candykingdom/gps-tracker/hardware/ref/board back.png

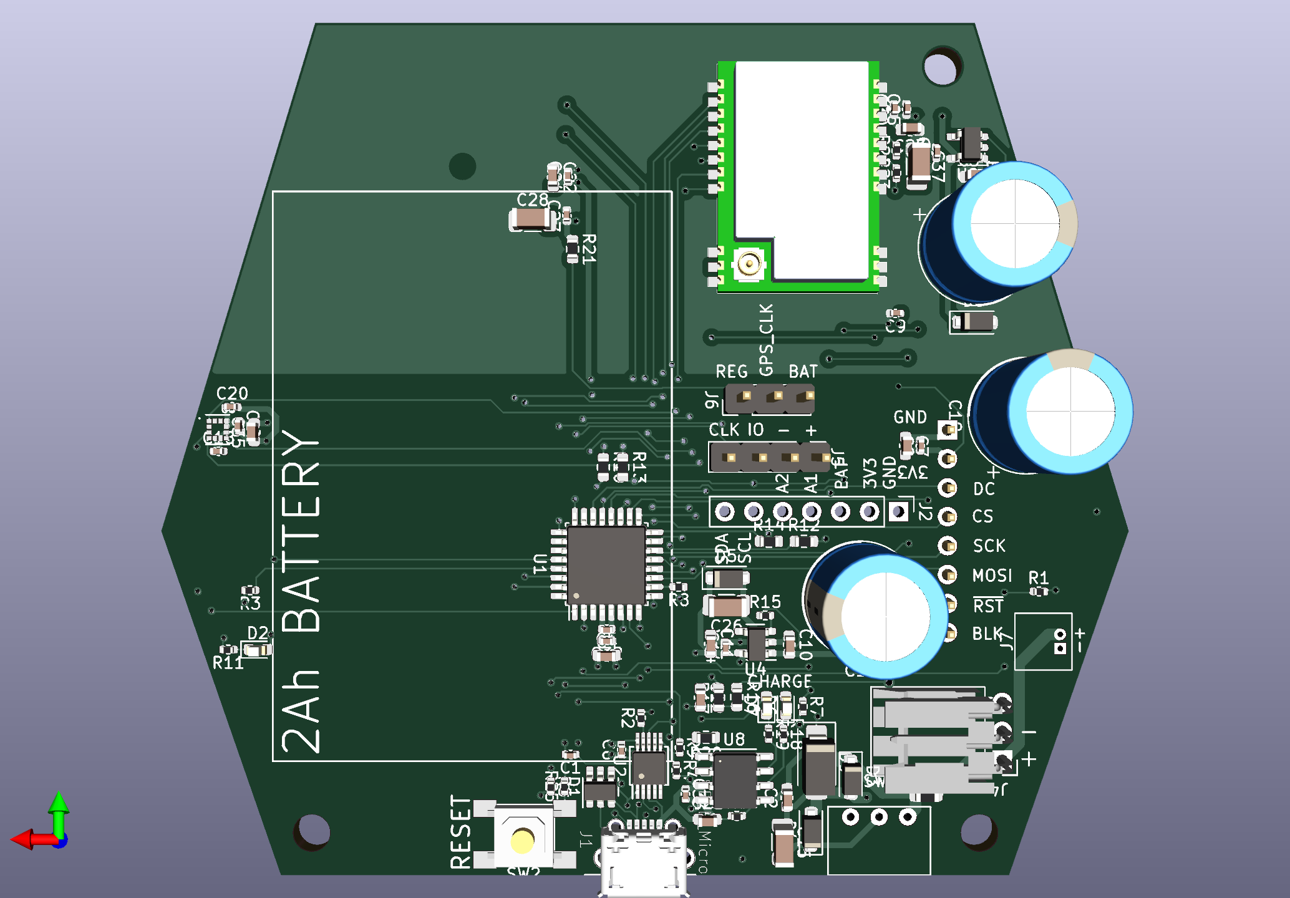
hardware/ref/board back.png
