candykingdom/gps-tracker/hardware/ref/board dimensions.png

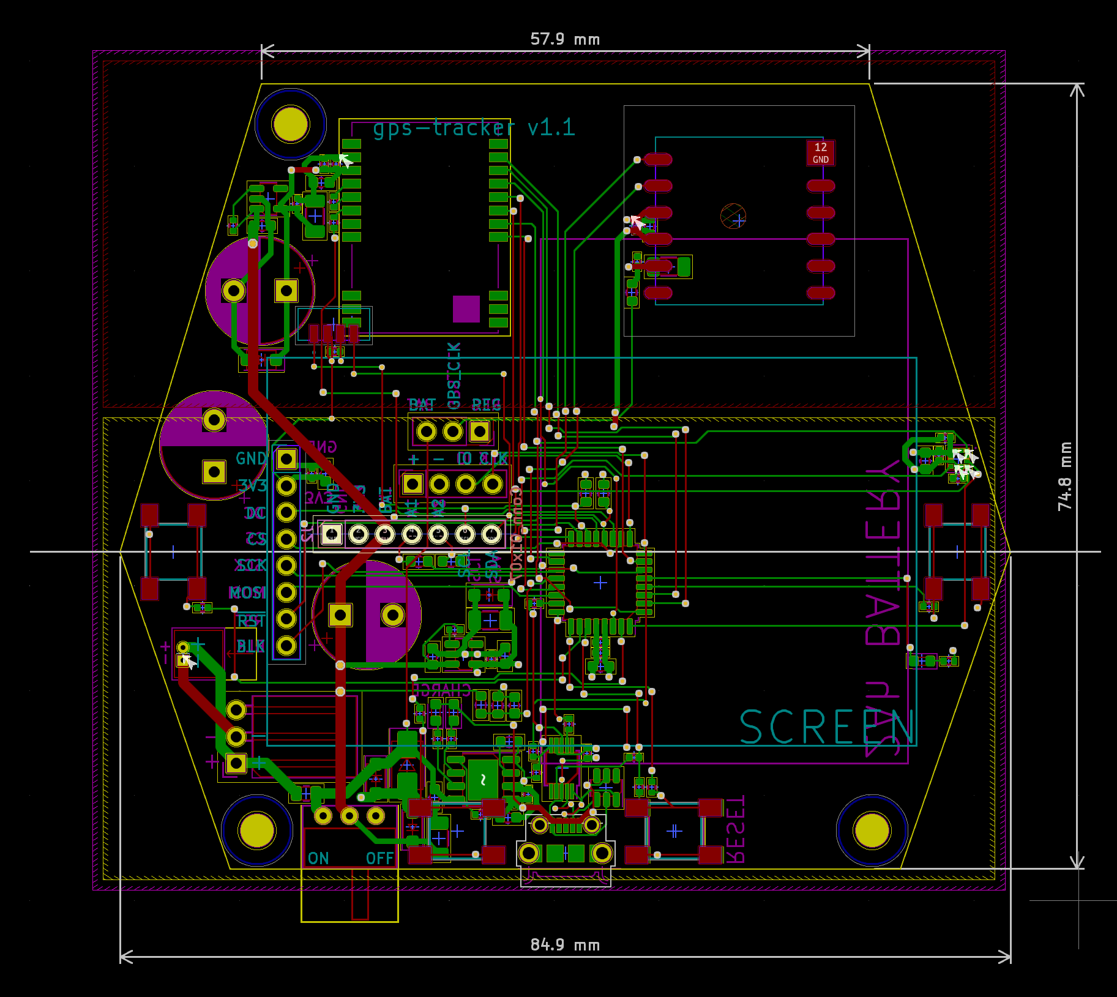
hardware/ref/board dimensions.png
