candykingdom/gps-tracker/hardware/ref/board front.png

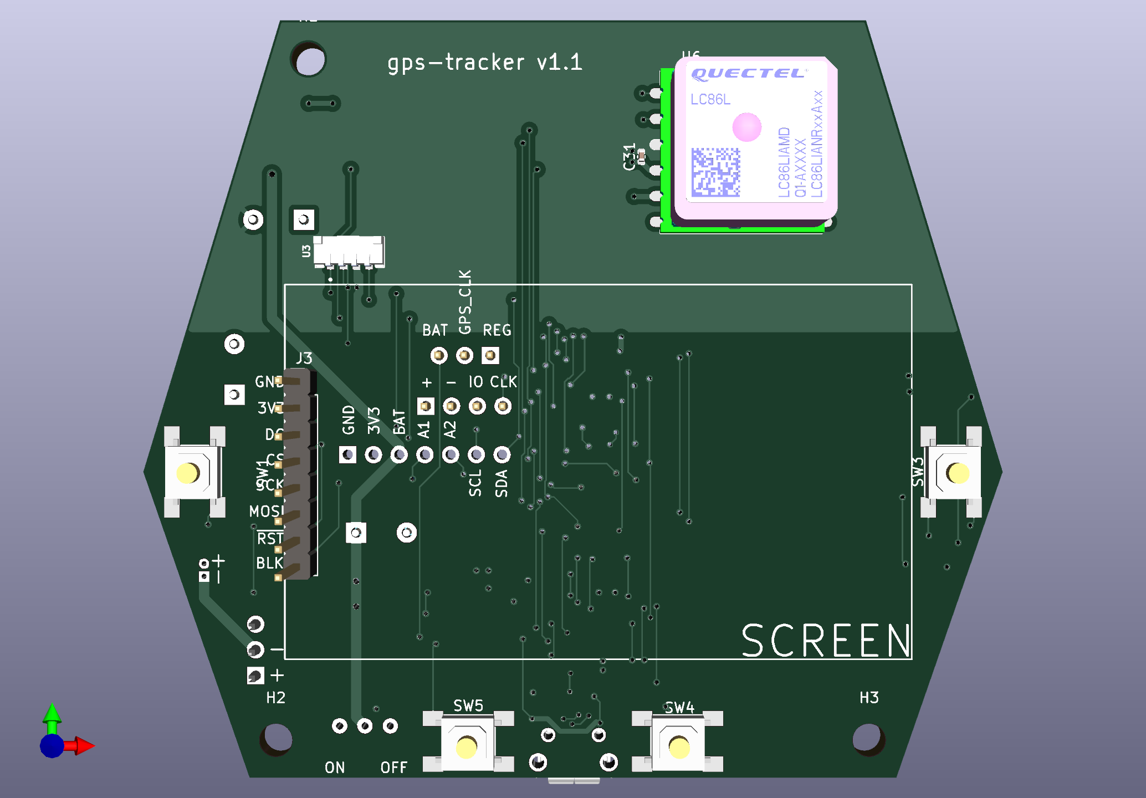
hardware/ref/board front.png
