candykingdom/gps-tracker/hardware/ref/FM24CL16B.png

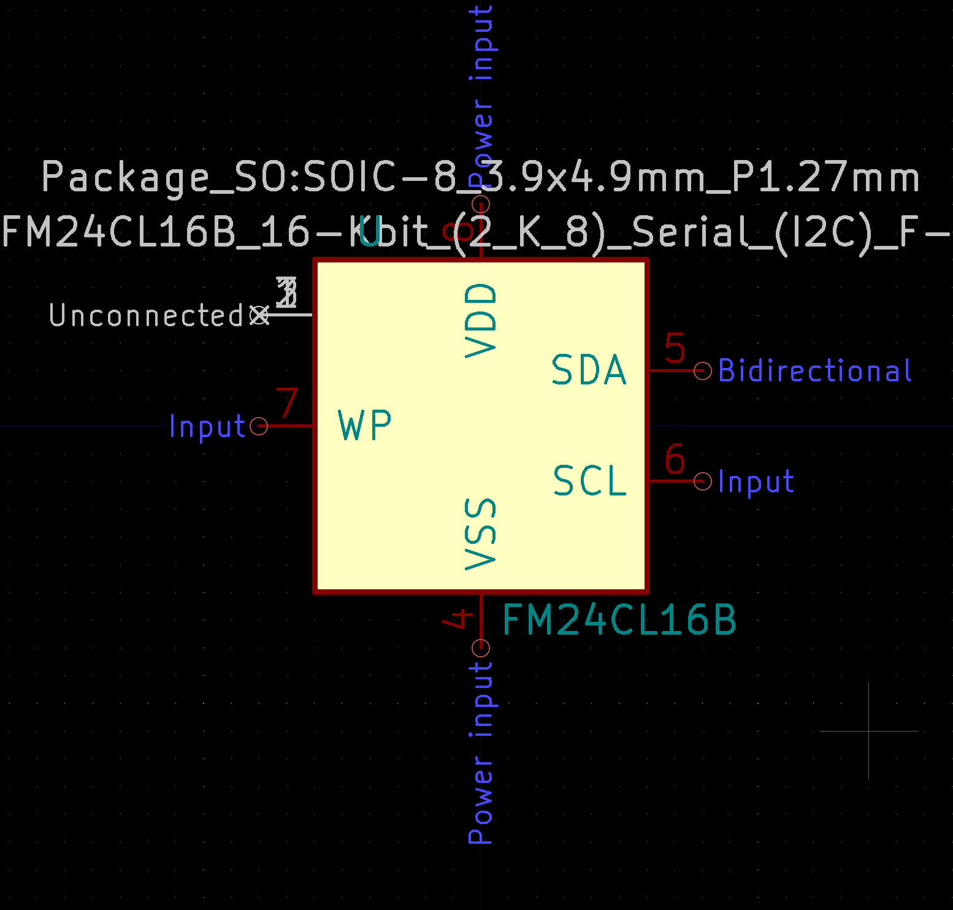
hardware/ref/FM24CL16B.png
