candykingdom/gps-tracker/hardware/ref/gps-tracker.pdf

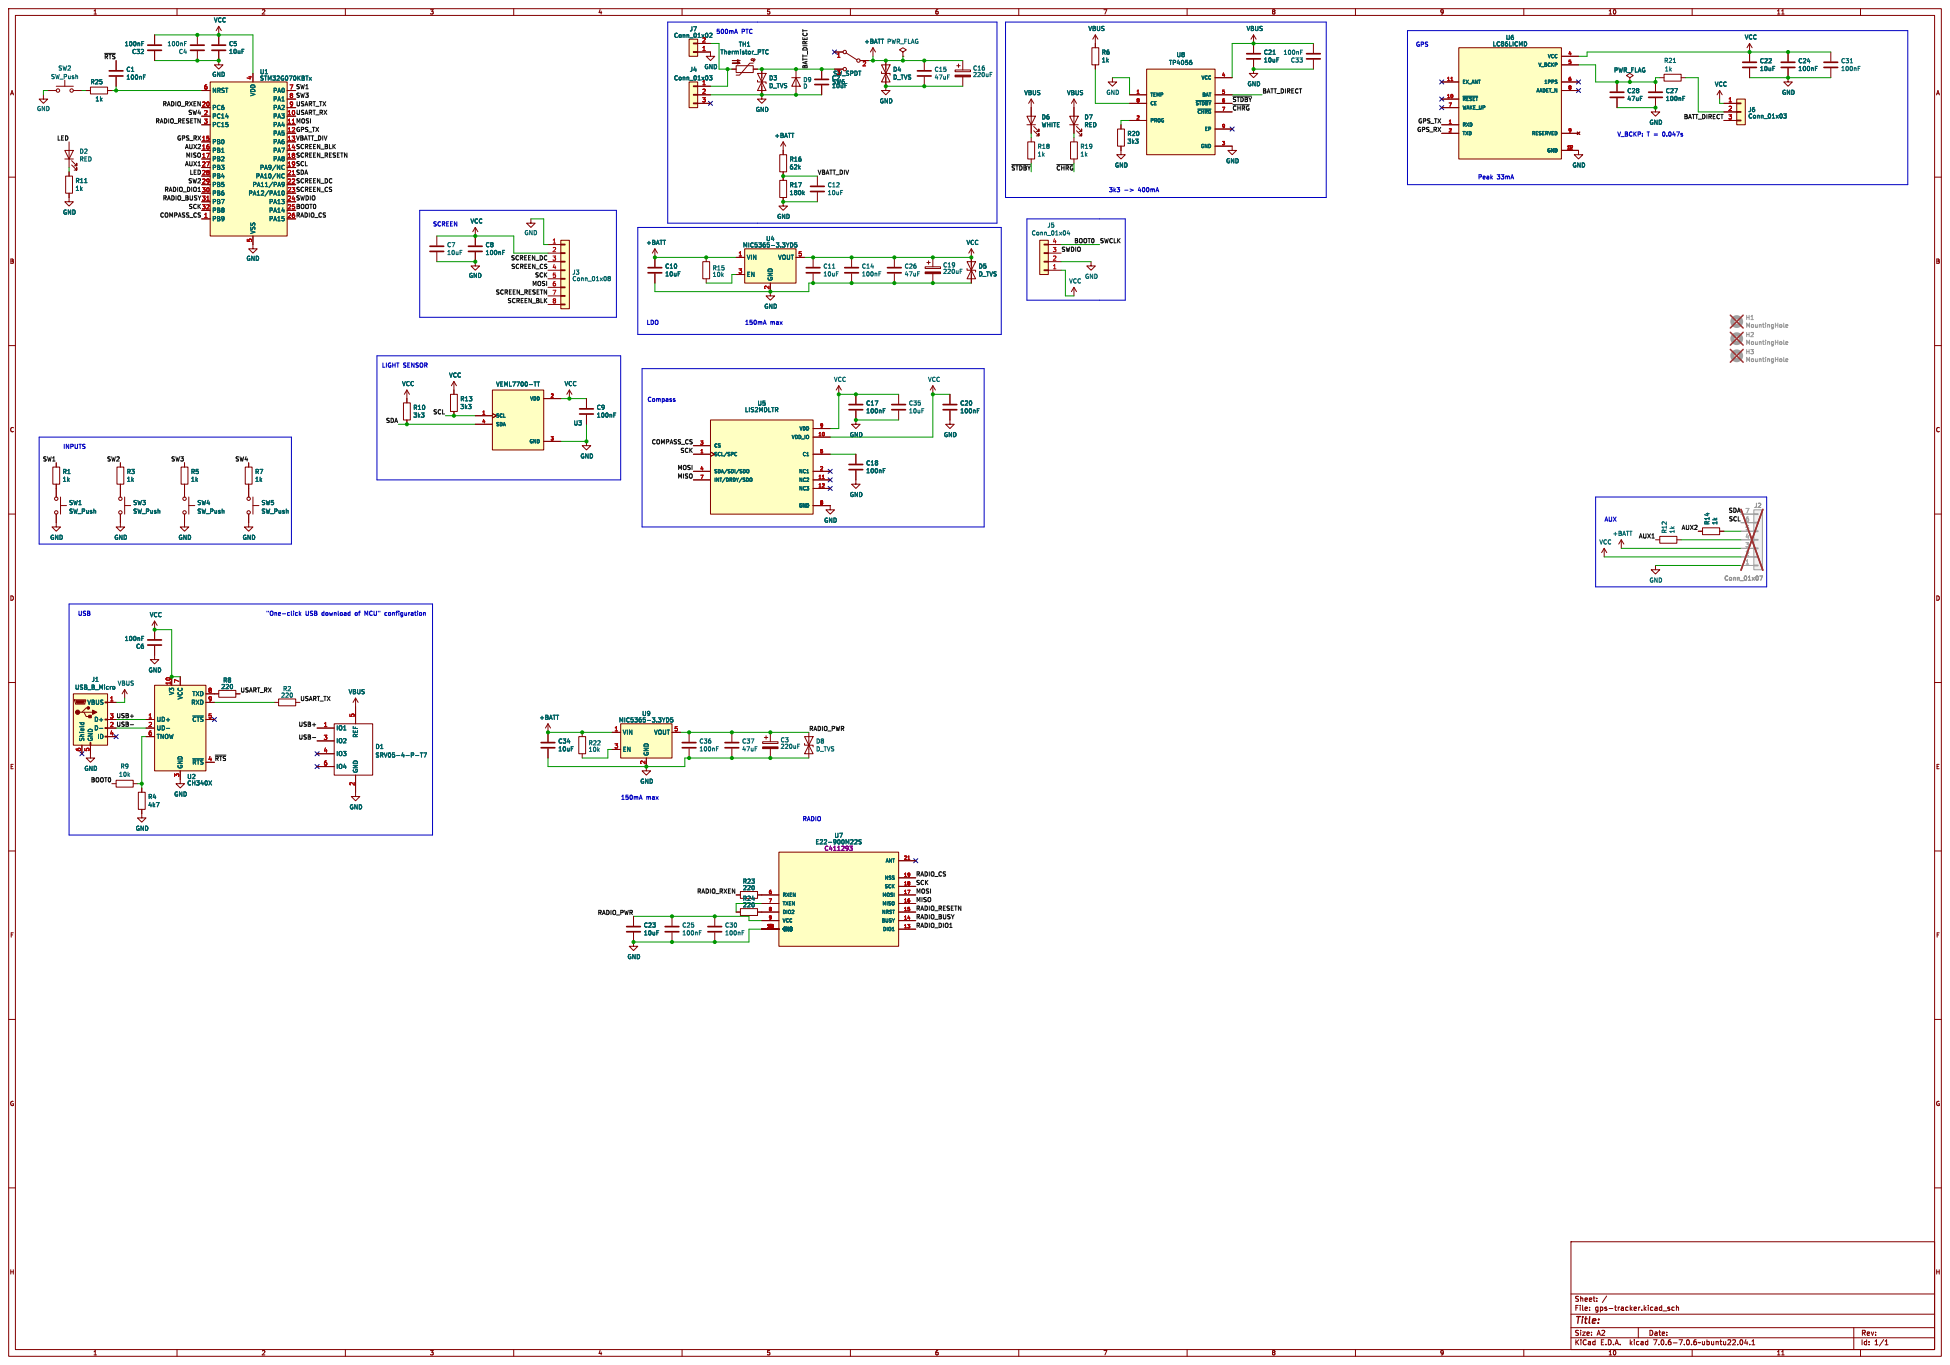
[picture p5: page 1]

2 EN 3 VOUT 5 VCC GND

J2 Conn_01x07 H2 MountingHole H3 MountingHole H1 MountingHole GND

3 ~{RTS}4 ~{CTS}5 TNOW 6 VCC
