candykingdom/gps-tracker/hardware/gps-tracker.kicad_pcb

## KiCad design hardware/gps-tracker.kicad_pcb (2023-07-22)

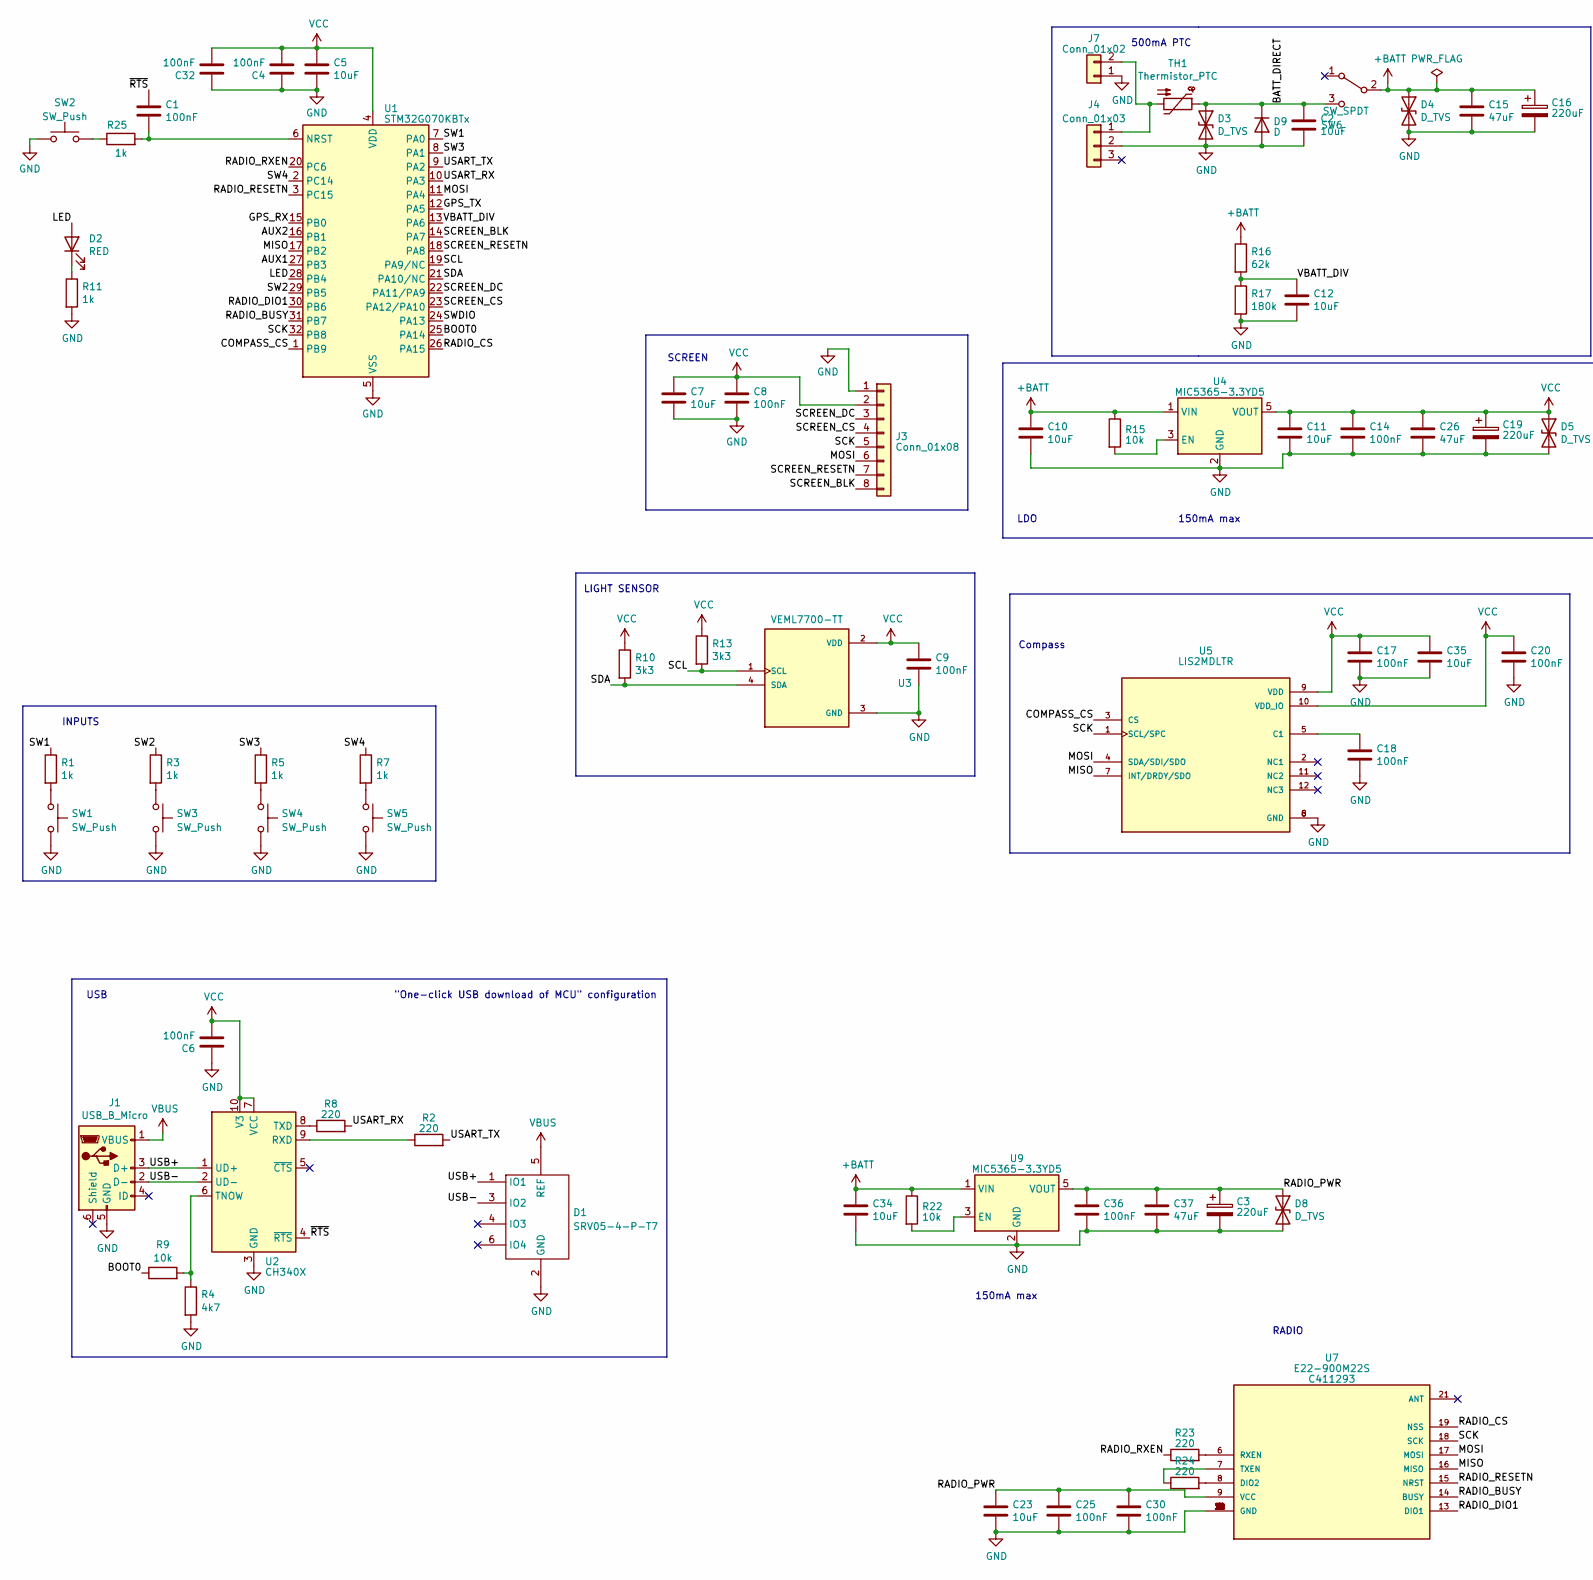
[picture p6: schematic gps-tracker.kicad_sch, part in row 1, column 1]

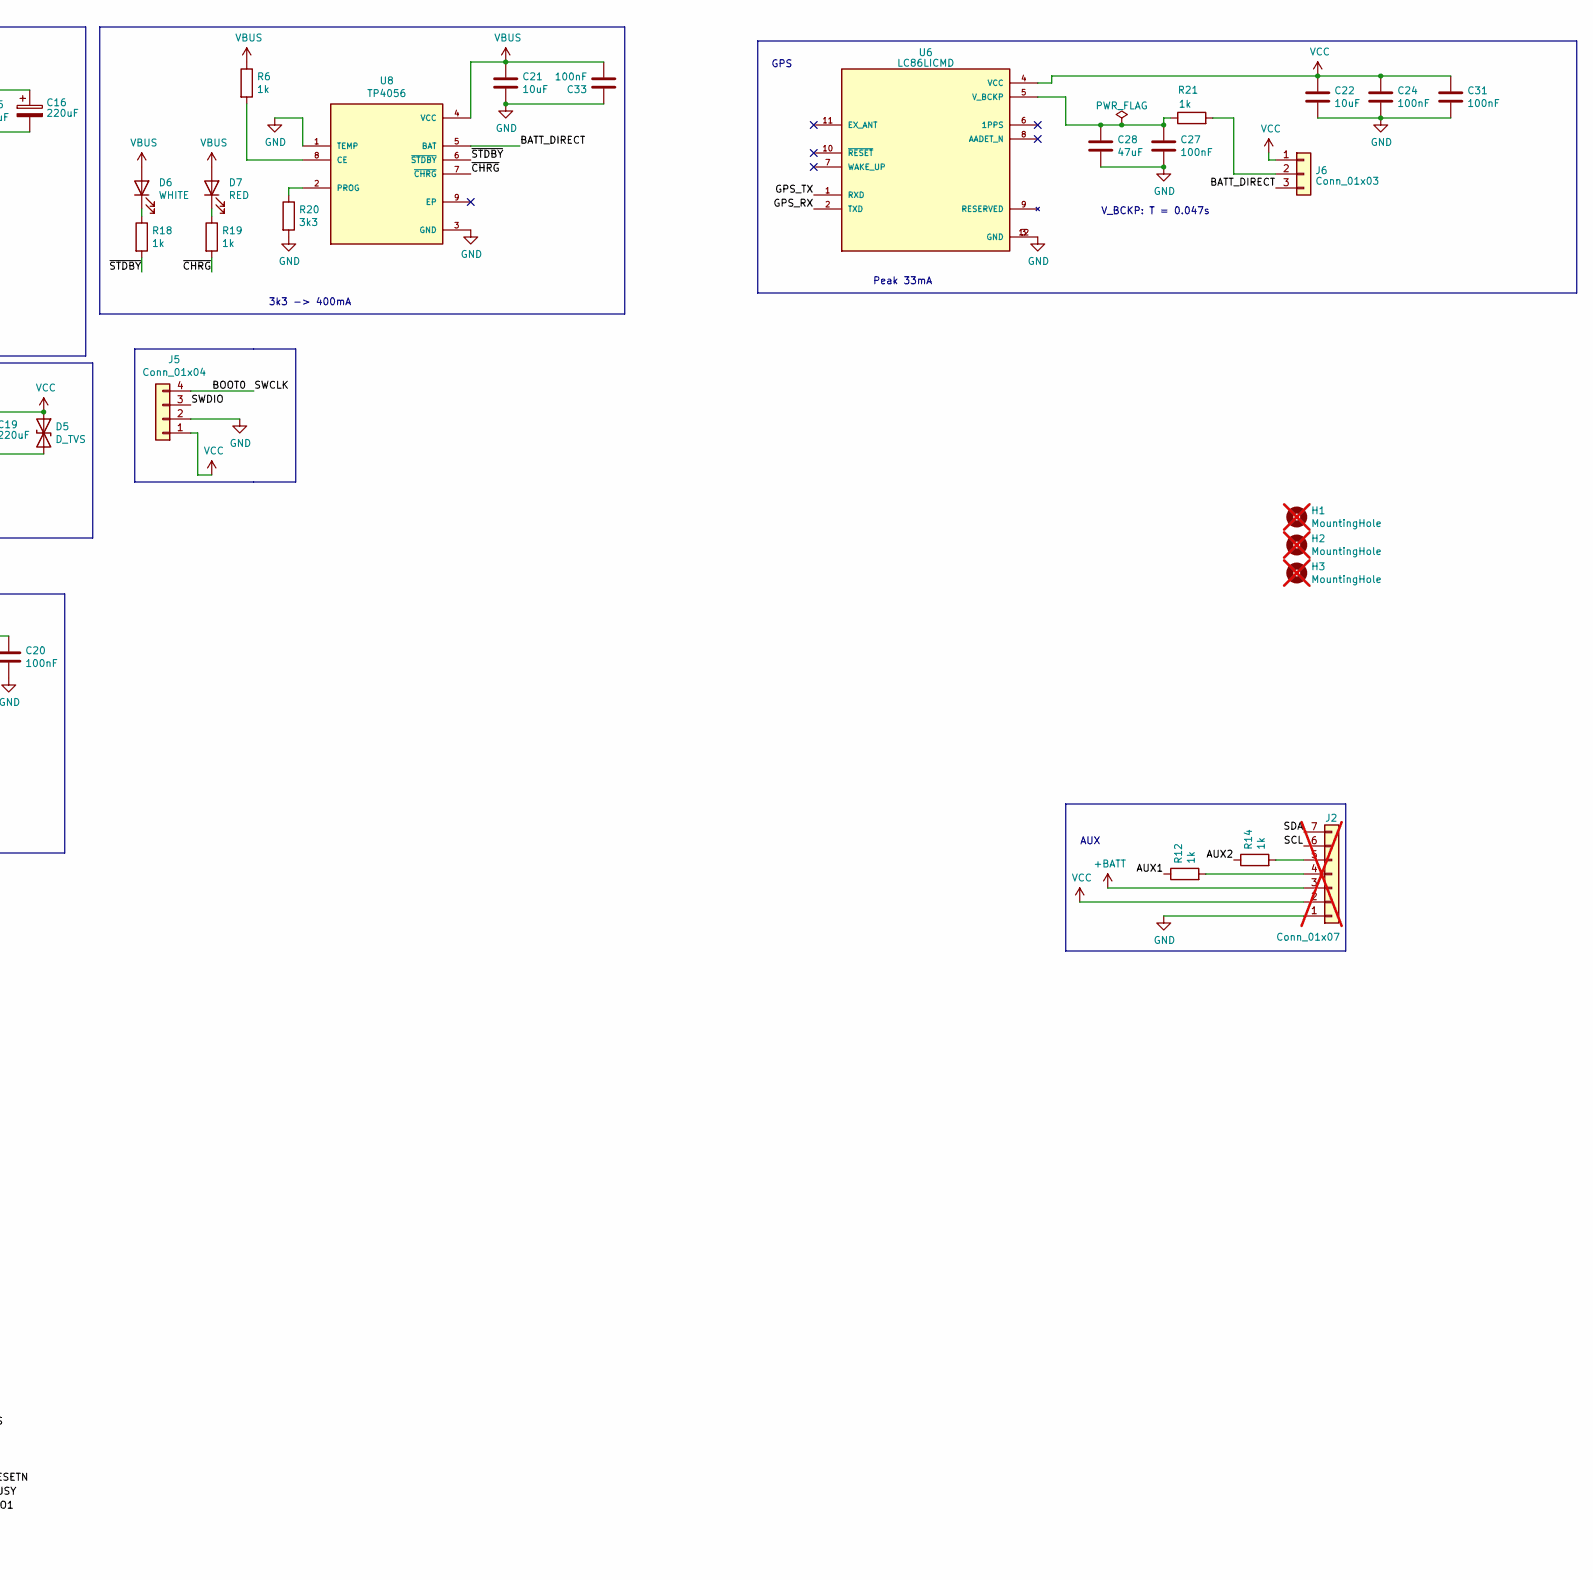
[picture p7: schematic gps-tracker.kicad_sch, part in row 1, column 2]

Parts:
C1, C4, C6, C8, C9, C14, C17, C18, C20, C24, C25, C27, C30, C31, C32, C33, C36: 100nF; C_0402_1005Metric; LCSC C307331
C2, C5, C7, C10, C11, C12, C21, C22, C23, C34, C35: 10uF; C_0603_1608Metric; LCSC C96446
C3, C16, C19: 220uF; CP_Radial_D10.0mm_P5.00mm; MPN ER1E221MP51007RU
C15, C26, C28, C37: 47uF; C_1206_3216Metric; LCSC C96123
D1: SRV05-4-P-T7; SOT-23-6; LCSC C85364
D2, D7: RED; LED_0603_1608Metric; LCSC C2286
D3, D4, D5, D8: D_TVS; D_SOD-123F; LCSC C2990473
D6: WHITE; LED_0603_1608Metric; LCSC C2290
D9: D; D_SMA; LCSC C8678
H1, H2, H3: MountingHole; MountingHole_3.2mm_M3; not fitted
J1: USB_B_Micro; FRAMATOME_10118194-0001LF_fixed_bridges; LCSC C132563
J2: Conn_01x07; PinHeader_1x07_P2.54mm_Vertical; not fitted
J3: Conn_01x08; PinHeader_1x08_P2.54mm_Vertical
J4: Conn_01x03; MiniPV_78208-X03XXX_1x03_P2.54mm_Polarized_Horizontal
J5: Conn_01x04; PinHeader_1x04_P2.54mm_Vertical
J6: Conn_01x03; PinHeader_1x03_P2.54mm_Vertical
J7: Conn_01x02; JST_Micro_1x02_P1.25mm_Horizontal
R1, R3, R5, R6, R7, R11, R18, R19, R25: 1k; R_0402_1005Metric; LCSC C11702
R2, R8, R23, R24: 220; R_0402_1005Metric; LCSC C25091
R4: 4k7; R_0402_1005Metric; LCSC C25900
R9, R15, R22: 10k; R_0402_1005Metric; LCSC C25744
R10, R13, R20: 3k3; R_0603_1608Metric; LCSC C22978
R12, R14, R21: 1k; R_0603_1608Metric; LCSC C21190
R16: 62k; R_0603_1608Metric; LCSC C23221
R17: 180k; R_0603_1608Metric; LCSC C22827
SW1, SW2, SW3, SW4, SW5: SW_Push; SW_TACTILE_5.1MM_TS-1187A-C-D-B; LCSC C318884
SW6: SW_SPDT; SS-12D03-G5; LCSC C698226
TH1: Thermistor_PTC; Fuse_0805_2012Metric; LCSC C269104
U1: STM32G070KBTx; LQFP-32_7x7mm_P0.8mm; LCSC C529339
U2: CH340X; MSOP-10_3x3mm_P0.5mm; LCSC C3035748
U3: VEML7700-TT; VISHAY_VEML7700-TT; PARTREV 1.6
U4, U9: MIC5365-3.3YD5; SOT-23-5; MPN MIC5365-3.3YD5
U5: LIS2MDLTR; PQFN50P200X200X70-12N; PARTREV Rev 5; LCSC C919695
U6: LC86LICMD; MODULE_LC86LICMD; MPN LC86LICMD
U7: E22-900M22S; LCSC C411293
U8: TP4056; SOP-8_3.9x4.9mm_P1.27mm_Thermal; LCSC C382139

Connections:
+BATT: C10.2, C15.2, C16.1, C34.2, D4.1 (A1), J2.3, R15.1, R16.1, R22.1, SW6.2 (B), U4.1 (VIN), U9.1 (VIN)
/AUX1: R12.1, U1.27 (PB3)
/AUX2: R14.1, U1.16 (PB1)
/BATT_DIRECT: C2.2, D3.1 (A1), D9.1 (K), J6.3, SW6.3 (C), TH1.1, U8.5 (BAT)
/BOOT0: J5.4, R9.1, U1.25 (PA14)
/COMPASS_CS: U1.1 (PB9), U5.3 (CS)
/GPS_RX: U1.15 (PB0), U6.2 (TXD)
/GPS_TX: U1.12 (PA5), U6.1 (RXD)
/LED: D2.2 (A), U1.28 (PB4)
/MISO: U1.17 (PB2), U5.7 (INT/DRDY/SDO), U7.16 (MISO)
/MOSI: J3.6, U1.11 (PA4), U5.4 (SDA/SDI/SDO), U7.17 (MOSI)
/RADIO_BUSY: U1.31 (PB7), U7.14 (BUSY)
/RADIO_CS: U1.26 (PA15), U7.19 (NSS)
/RADIO_DIO1: U1.30 (PB6), U7.13 (DIO1)
/RADIO_PWR: C3.1, C23.2, C25.1, C30.1, C36.1, C37.2, D8.1 (A1), U7.9 (VCC), U9.5 (VOUT)
/RADIO_RESETN: U1.3 (PC15), U7.15 (NRST)
/RADIO_RXEN: R23.1, U1.20 (PC6)
/SCK: J3.5, U1.32 (PB8), U5.1 (SCL/SPC), U7.18 (SCK)
/SCL: J2.6, R13.2, U1.19 (PA9/NC), U3.1 (SCL)
/SCREEN_BLK: J3.8, U1.14 (PA7)
/SCREEN_CS: J3.4, U1.23 (PA12/PA10)
/SCREEN_DC: J3.3, U1.22 (PA11/PA9)
/SCREEN_RESETN: J3.7, U1.18 (PA8)
/SDA: J2.7, R10.2, U1.21 (PA10/NC), U3.4 (SDA)
/SW1: R1.1, U1.7 (PA0)
/SW2: R3.1, U1.29 (PB5)
/SW3: R5.1, U1.8 (PA1)
/SW4: R7.1, U1.2 (PC14)
/SWDIO: J5.3, U1.24 (PA13)
/USART_RX: R8.2, U1.10 (PA3)
/USART_TX: R2.2, U1.9 (PA2)
/USB+: D1.1 (IO1), J1.3 (D+), U2.1 (UD+)
/USB-: D1.3 (IO2), J1.2 (D-), U2.2 (UD-)
/VBATT_DIV: C12.2, R16.2, R17.1, U1.13 (PA6)
/~CHRG: R19.2, U8.7 (~CHRG)
/~RTS: C1.1, U2.4 (~RTS)
/~STDBY: R18.2, U8.6 (~STDBY)
GND: C2.1, C3.2, C4.1, C5.2, C6.1, C7.1, C8.2, C9.2, C10.1, C11.1, C12.1, C14.2, C15.1, C16.2, C17.2, C18.2, C19.2, C20.2, C21.1, C22.1, C23.1, C24.2, C25.2, C26.1, C27.2, C28.1, C30.2, C31.2, C32.1, C33.1, C34.1, C35.1, C36.2, C37.1, D1.2 (GND), D3.2 (A2), D4.2 (A2), D5.2 (A2), D8.2 (A2), D9.2 (A), J1.5 (GND), J2.1, J3.1, J4.2, J5.2, J7.1, R4.2, R11.2, R17.2, R20.2, SW1.2, SW2.1, SW3.2, SW4.2, SW5.2, U1.5 (VSS), U2.3 (GND), U3.3 (GND), U4.2 (GND), U5.6 (GND), U5.8 (GND), U6.3 (GND), U6.12 (GND), U7.1 (GND), U7.2 (GND), U7.3 (GND), U7.4 (GND), U7.5 (GND), U7.10 (GND), U7.11 (GND), U7.12 (GND), U7.20 (GND), U7.22 (GND), U8.1 (TEMP), U8.3 (GND), U9.2 (GND)
unnamed: D2.1 (K), R11.1
unnamed: D6.1 (K), R18.1
unnamed: D7.1 (K), R19.1
unnamed: J2.4, R12.2
unnamed: J2.5, R14.2
unnamed: J4.1, J7.2, TH1.2
unnamed: J6.2, R21.2
unnamed: R1.2, SW1.1
unnamed: R3.2, SW3.1
unnamed: R5.2, SW4.1
unnamed: R7.2, SW5.1
unnamed: R25.1, SW2.2
unnamed: C1.2, R25.2, U1.6 (NRST)
unnamed: R2.1, U2.9 (RXD)
unnamed: R4.1, R9.2, U2.6 (TNOW)
unnamed: R8.1, U2.8 (TXD)
unnamed: R15.2, U4.3 (EN)
unnamed: C18.1, U5.5 (C1)
unnamed: C27.1, C28.2, R21.1, U6.5 (V_BCKP)
unnamed: R24.2, U7.8 (DIO2)
unnamed: R23.2, U7.6 (RXEN)
unnamed: R24.1, U7.7 (TXEN)
unnamed: R6.2, U8.8 (CE)
unnamed: R20.1, U8.2 (PROG)
unnamed: R22.2, U9.3 (EN)
VBUS: C21.2, C33.2, D1.5 (REF), D6.2 (A), D7.2 (A), J1.1 (VBUS), R6.1, U8.4 (VCC)
VCC: C4.2, C5.1, C6.2, C7.2, C8.1, C9.1, C11.2, C14.1, C17.1, C19.1, C20.1, C22.2, C24.1, C26.2, C31.1, C32.2, C35.2, D5.1 (A1), J2.2, J3.2, J5.1, J6.1, R10.1, R13.1, U1.4 (VDD), U2.7 (VCC), U2.10 (V3), U3.2 (VDD), U4.5 (VOUT), U5.9 (VDD), U5.10 (VDD_IO), U6.4 (VCC)

Notes on the sheet:
Peak 33mA
RADIO
INPUTS
AUX
3k3 -> 400mA
USB
500mA PTC
LIGHT SENSOR
"One-click USB download of MCU" configuration
150mA max
GPS
Compass
V_BCKP: T = 0.047s
SCREEN
LDO

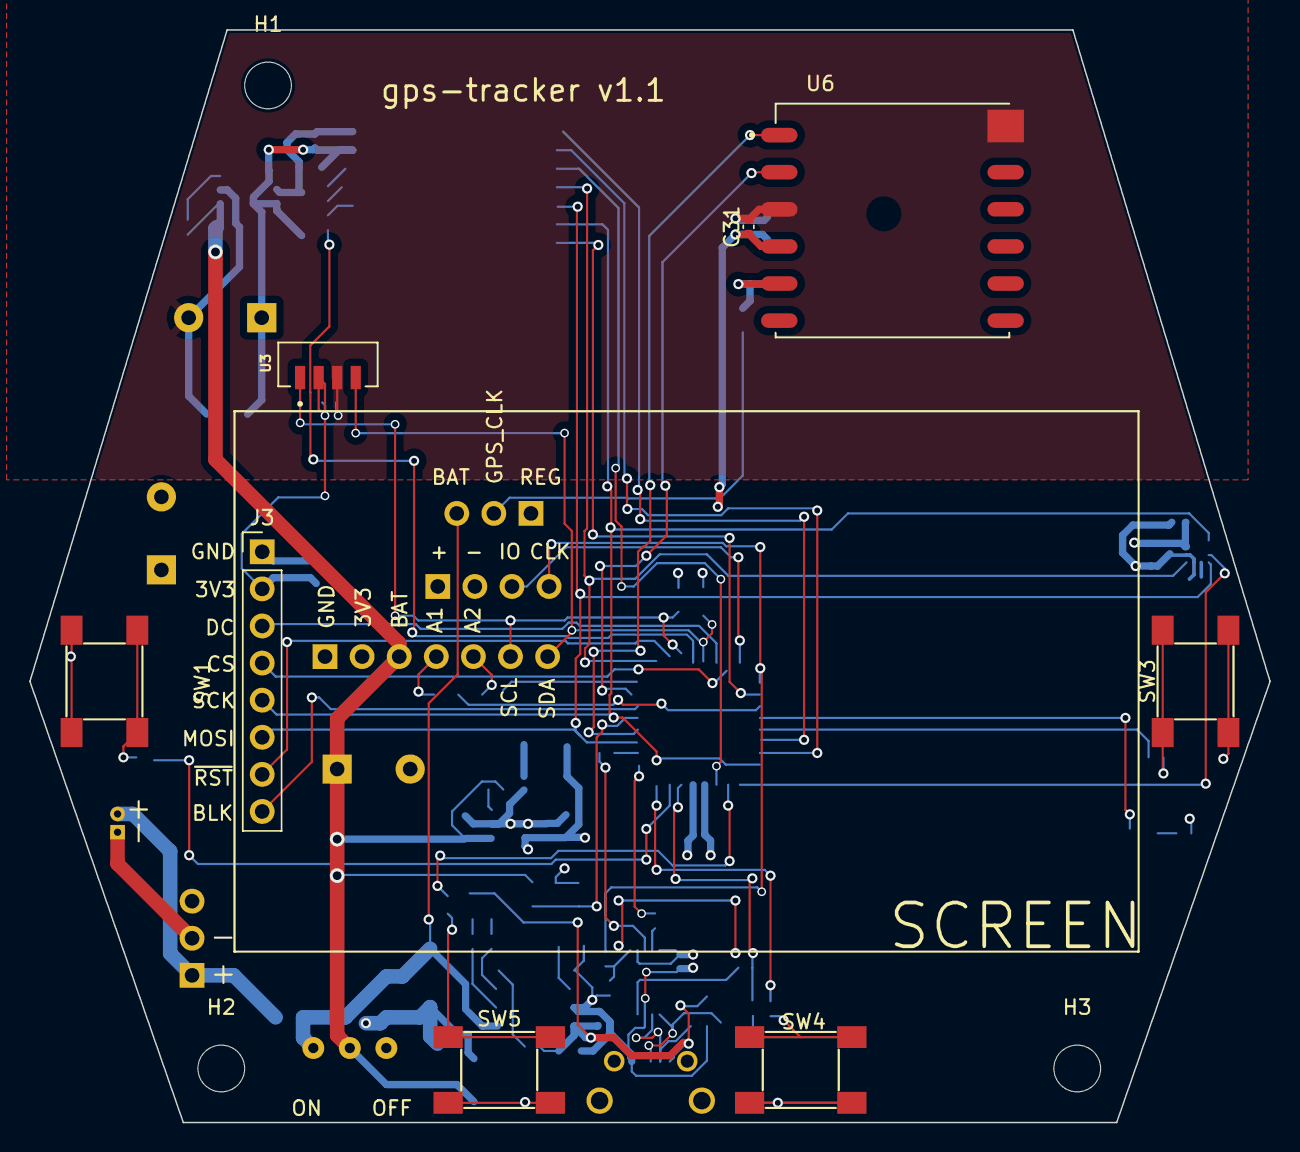
[picture p8: board gps-tracker.kicad_pcb from above]

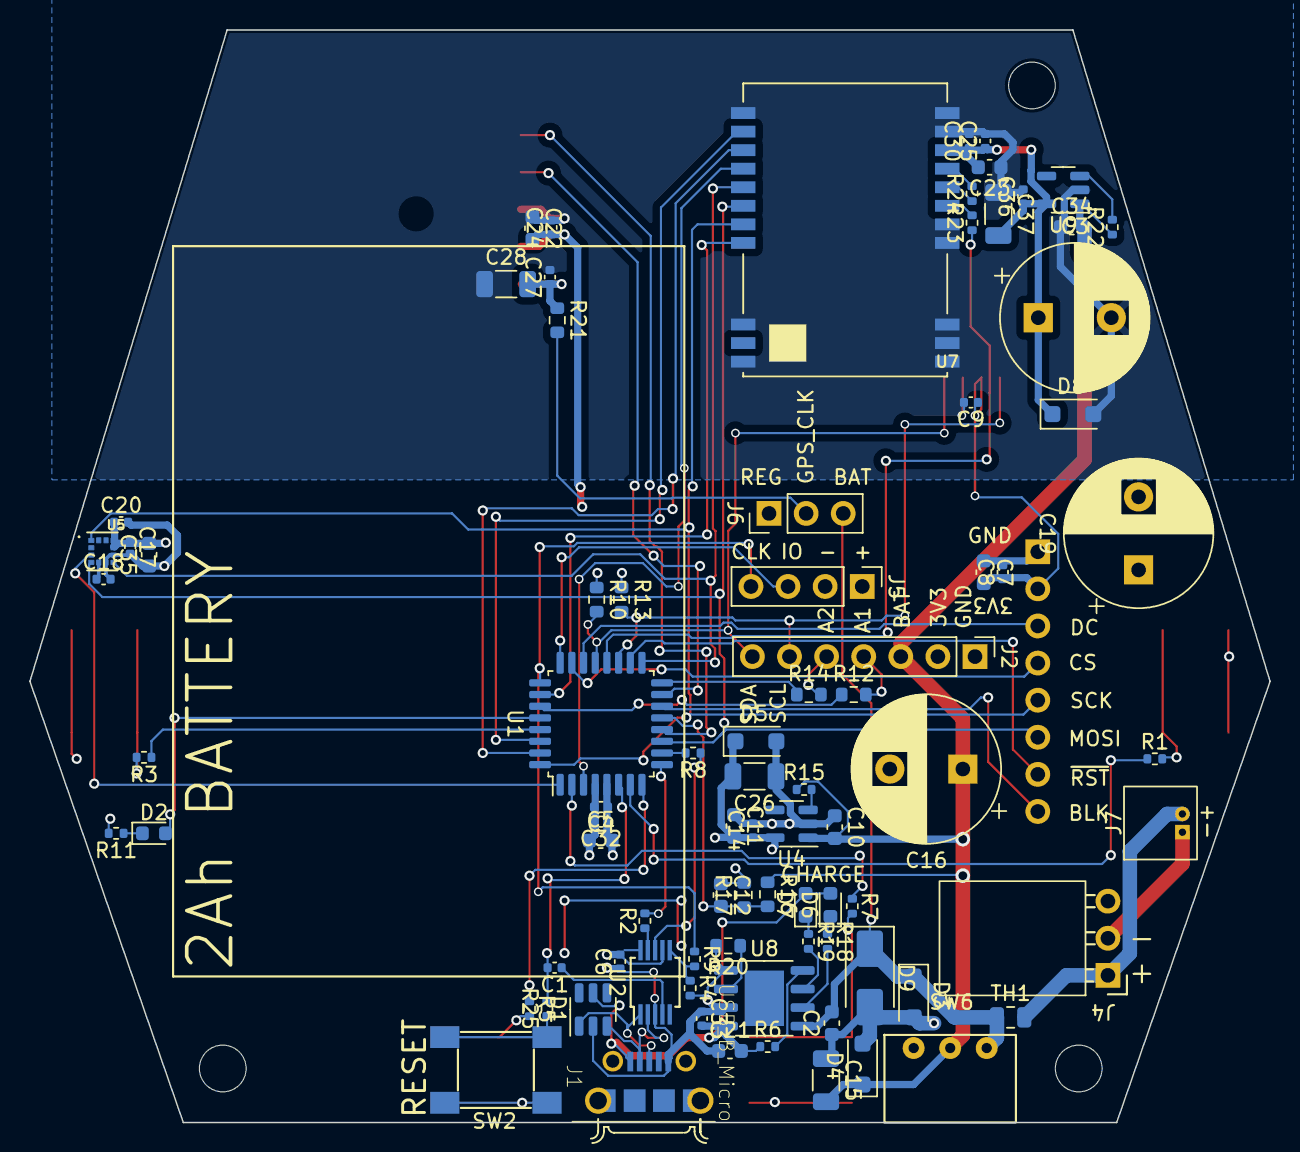
[picture p9: board gps-tracker.kicad_pcb from below]

Board: 4 copper layers, 84.9 x 74.8 mm, 95 parts (84 on the bottom side), 65 nets.
