candykingdom/gps-tracker/(commit log)

2023-02-16 Start defining schematic - add processor
    [gps-tracker.kicad_pcb, gps-tracker.kicad_sch]
2023-02-19 First pass at schematic
    [gps-tracker.kicad_sch]
2023-02-19 Update part numbers and footprints
    [gps-tracker.kicad_sch]
2023-02-20 Update to lower-power SPI radio module
    [gps-tracker.kicad_pcb, gps-tracker.kicad_sch]
2023-02-25 First pass at PCB positions
    [gps-tracker.kicad_pcb, gps-tracker.kicad_sch]
2023-04-07 Hardware v1.0
    [gps-tracker-B_Cu.gbl, gps-tracker-B_Mask.gbs, gps-tracker-B_Paste.gbp, gps-tracker-B_Silkscreen.gbo, gps-tracker-Edge_Cuts.gm1, gps-tracker-F_Cu.gtl, gps-tracker-F_Mask.gts, gps-tracker-F_Paste.gtp]
2023-04-07 Some fixes for hardware v1.0
    [gps-tracker.kicad_pcb, gps-tracker.kicad_sch]
2023-04-07 Include CSV files
    [gps-tracker_bom_jlc.csv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]
2023-04-07 Fix compass rotation in cpl
    [gps-tracker_cpl_jlc.csv]
2023-04-19 Add 3d model for pcb
    [gps-tracker.kicad_pcb]
2023-04-21 Add software; read from compass
    [gps-tracker.kicad_pcb]
2023-07-13 Add test code for light sensor
2023-07-13 Add a function for hard-iron calibrating the compass
2023-07-14 Fix GPS location dump to not sleep
    [gps-tracker.ino]
2023-07-15 Pin the TinyGPS++ library version
2023-07-15 Ignore more KiCAD temp files
2023-07-20 Add LoRa distance tester
    [gps-tracker.kicad_sch]
2023-07-22 Hardware revision v1.1:
    - Switch to (hopefully) easier-to-solder light sensor
    - Fix bootloader situation: use "One-click USB download of MCU" configuration from CH340 datasheet
    - Connect radio reset line to MCU
    - (Slightly) increase clearance for hand-soldering voltage regulators
    [gps-tracker-B_Cu.gbl, gps-tracker-B_Mask.gbs, gps-tracker-B_Paste.gbp, gps-tracker-B_Silkscreen.gbo, gps-tracker-Edge_Cuts.gm1, gps-tracker-F_Cu.gtl, gps-tracker-F_Mask.gts, gps-tracker-F_Paste.gtp]
2023-08-04 Add documentation for radio power consumption
